KAVYAJOSHI1/PUREROUTE/app.py

"""
PureRoute v2 — Professional Industrial Water Monitoring & Decision Console
Designed for high-reliability municipal & decentralized water purification systems.
Design Language: Minimal, functional, data-first industrial SCADA (Linear / Vercel / Stripe standard).
"""

import os
import time
from datetime import datetime, date, timedelta
from typing import Dict, Any, List, Optional
import pandas as pd
import streamlit as st

from engine.decision_engine import DecisionEngine, State, CalibrationConstants
from engine.lock_module import AreaLockEngine, BIS_LIMITS, PARAM_LABELS
from engine.simulator import WaterRigSimulator
from engine.serial_reader import SerialManager
from engine.ui_components import (
    clean_html,
    render_status_badge,
    render_connection_chip,
    render_top_header,
    render_system_status_banner,
    render_metric_card,
    render_filter_health_card,
    render_decision_matrix_table,
    create_light_telemetry_chart,
    render_card_header,
    render_contaminant_indicator_card
)
from tools.calibration_helper import CalibrationHelper

# ---------------------------------------------------------
# Page Configuration & Global Industrial Theme
# ---------------------------------------------------------
st.set_page_config(
    page_title="PureRoute — Industrial Water Monitoring & Decision Console",
    page_icon="💧",
    layout="wide",
    initial_sidebar_state="expanded"
)

# Professional Industrial Styling (Light Mode strictly)
st.markdown("""
<style>
    @import url('https://fonts.googleapis.com/css2?family=Inter:wght@400;500;600;700&family=JetBrains+Mono:wght@400;500;600&display=swap');

    /* Remove Streamlit Default Chrome */
    #MainMenu { visibility: hidden !important; }
    footer { visibility: hidden !important; }
    header, .stAppHeader, header[data-testid="stHeader"] { display: none !important; }
    .stDeployButton, div[data-testid="stAppDeployButton"] { display: none !important; }
    div[data-testid="stDecoration"] { display: none !important; }

    /* Global Foundation */
    .stApp {
        background-color: #F7F8FA !important;
        color: #20242B !important;
        font-family: 'Inter', -apple-system, BlinkMacSystemFont, 'Segoe UI', Roboto, sans-serif !important;
    }

    /* Fixed Left Sidebar (240px) */
    section[data-testid="stSidebar"] {
        width: 240px !important;
        background-color: #FFFFFF !important;
        border-right: 1px solid #E5E7EB !important;
        padding-top: 1rem !important;
    }
    section[data-testid="stSidebar"] .block-container {
        padding-top: 1rem !important;
        padding-bottom: 2rem !important;
        padding-left: 14px !important;
        padding-right: 14px !important;
    }

    /* Brand Header in Sidebar */
    .brand-container {
        padding: 0 4px 16px 4px;
        border-bottom: 1px solid #E5E7EB;
        margin-bottom: 16px;
    }
    .brand-title {
        font-family: 'Inter', sans-serif;
        font-size: 16px;
        font-weight: 700;
        color: #20242B;
        letter-spacing: -0.02em;
        display: flex;
        align-items: center;
        gap: 8px;
    }
    .brand-sub {
        font-size: 10px;
        font-weight: 600;
        color: #68717D;
        margin-top: 3px;
        text-transform: uppercase;
        letter-spacing: 0.06em;
    }

    /* Navigation Radio Items Restyled into Linear-Style Sidebar Links */
    div[data-testid="stRadio"] div[data-testid="stRadioGroup"] {
        gap: 3px !important;
    }
    label[data-testid="stRadioOption"] {
        background-color: transparent !important;
        border: 1px solid transparent !important;
        border-radius: 6px !important;
        padding: 7px 10px !important;
        margin-bottom: 2px !important;
        width: 100% !important;
        display: flex !important;
        align-items: center !important;
        cursor: pointer !important;
        transition: all 0.12s ease !important;
    }
    /* Hide the radio circle completely */
    label[data-testid="stRadioOption"] > div > div:first-child {
        display: none !important;
    }
    label[data-testid="stRadioOption"] > div {
        display: flex !important;
        align-items: center !important;
        width: 100% !important;
    }
    label[data-testid="stRadioOption"] p {
        font-size: 13px !important;
        font-weight: 500 !important;
        color: #4B5563 !important;
        margin: 0 !important;
        line-height: 1.4 !important;
    }
    label[data-testid="stRadioOption"]:hover {
        background-color: #F3F4F6 !important;
    }
    label[data-testid="stRadioOption"]:hover p {
        color: #111827 !important;
    }
    label[data-testid="stRadioOption"][data-selected="true"],
    label[data-testid="stRadioOption"]:has(input:checked) {
        background-color: #EDF2F5 !important;
        border-color: #D0DCE3 !important;
    }
    label[data-testid="stRadioOption"][data-selected="true"] p,
    label[data-testid="stRadioOption"]:has(input:checked) p {
        color: #315B73 !important;
        font-weight: 600 !important;
    }

    /* Main Content Container (Max 1500px, 24px padding) */
    .main .block-container {
        max-width: 1500px !important;
        padding: 20px 32px 48px 32px !important;
    }

    /* Industrial Card Surface */
    .pr-card {
        background: #FFFFFF;
        border: 1px solid #E5E7EB;
        border-radius: 6px;
        padding: 16px 20px;
        margin-bottom: 16px;
        box-shadow: 0 1px 2px rgba(0,0,0,0.02);
    }
    .pr-card-header {
        display: flex;
        justify-content: space-between;
        align-items: center;
        margin-bottom: 12px;
        padding-bottom: 8px;
        border-bottom: 1px solid #F1F3F5;
    }
    .pr-card-title {
        font-size: 12px;
        font-weight: 600;
        text-transform: uppercase;
        letter-spacing: 0.05em;
        color: #68717D;
    }

    /* Enterprise Clean Button Styling */
    div.stButton > button {
        background-color: #FFFFFF !important;
        color: #20242B !important;
        border: 1px solid #D1D5DB !important;
        border-radius: 5px !important;
        font-size: 13px !important;
        font-weight: 500 !important;
        padding: 6px 14px !important;
        box-shadow: 0 1px 2px rgba(0,0,0,0.03) !important;
        transition: all 0.12s ease !important;
    }
    div.stButton > button:hover {
        background-color: #F9FAFB !important;
        border-color: #9CA3AF !important;
        color: #111827 !important;
    }
    div.stButton > button:active {
        background-color: #F3F4F6 !important;
    }

    /* Danger / Primary Button Overrides */
    div.stButton > button[kind="primary"],
    div.stButton > button[data-testid="baseButton-primary"] {
        background-color: #B94A48 !important;
        color: #FFFFFF !important;
        border-color: #93302E !important;
    }
    div.stButton > button[kind="primary"]:hover,
    div.stButton > button[data-testid="baseButton-primary"]:hover {
        background-color: #93302E !important;
    }

    /* Native Container Card Surfaces (st.container(border=True)) */
    div[data-testid="stVerticalBlockBorderWrapper"] {
        background-color: #FFFFFF !important;
        border: 1px solid #E5E7EB !important;
        border-radius: 6px !important;
        padding: 16px 20px !important;
        margin-bottom: 16px !important;
        box-shadow: 0 1px 2px rgba(0,0,0,0.02) !important;
    }

    /* Selectbox Dropdown Options and Value styling */
    div[data-baseweb="select"],
    div[data-baseweb="select"] * {
        background-color: #FFFFFF !important;
        color: #20242B !important;
    }
    div[data-baseweb="select"] > div {
        background-color: #FFFFFF !important;
        color: #20242B !important;
        border: 1px solid #D1D5DB !important;
        border-radius: 5px !important;
    }
    div[data-baseweb="popover"],
    div[data-baseweb="popover"] *,
    div[data-baseweb="menu"],
    div[data-baseweb="menu"] * {
        background-color: #FFFFFF !important;
        color: #20242B !important;
    }
    div[data-baseweb="calendar"],
    div[data-baseweb="calendar"] * {
        background-color: #FFFFFF !important;
        color: #20242B !important;
    }
    li[data-baseweb="menu-item"]:hover {
        background-color: #F3F4F6 !important;
    }

    /* Text & Select Inputs */
    div[data-baseweb="input"],
    div[data-baseweb="base-input"],
    div[data-testid="stTextInputRootElement"],
    div[data-testid="stNumberInputContainer"],
    div[data-testid="stDateInput"] > div {
        background-color: #FFFFFF !important;
        border: 1px solid #D1D5DB !important;
        border-radius: 5px !important;
    }
    div[data-baseweb="input"] input,
    div[data-baseweb="base-input"] input,
    input[data-testid="stTextInputField"],
    div[data-testid="stNumberInputContainer"] input,
    div[data-testid="stDateInput"] input {
        background-color: #FFFFFF !important;
        color: #20242B !important;
        font-family: 'JetBrains Mono', monospace !important;
        font-size: 13px !important;
    }

    /* Tables & DataFrames */
    .stDataFrame {
        border: 1px solid #E5E7EB !important;
        border-radius: 6px !important;
        background: #FFFFFF !important;
    }

    /* Monospace Code blocks */
    code, pre {
        font-family: 'JetBrains Mono', monospace !important;
    }
</style>
""", unsafe_allow_html=True)

# ---------------------------------------------------------
# Session State Initialization
# ---------------------------------------------------------
if "engine" not in st.session_state:
    st.session_state.engine = DecisionEngine()
if "simulator" not in st.session_state:
    st.session_state.simulator = WaterRigSimulator(st.session_state.engine)
if "lock_engine" not in st.session_state:
    st.session_state.lock_engine = AreaLockEngine("district_risk.csv")
if "data_history" not in st.session_state:
    st.session_state.data_history = []
if "log_filename" not in st.session_state:
    st.session_state.log_filename = time.strftime("run_%Y%m%d_%H%M%S.csv")
    with open(st.session_state.log_filename, "w", encoding="utf-8") as f:
        f.write("t_ms,temp_c,flow_lpm,pulses,turb_mv,turb_index_pct,ec25_uScm,tds_ppm,fhi,counter_life_pct,pump,lock,state,reason,tag\n")

if "serial_manager" not in st.session_state:
    st.session_state.serial_manager = SerialManager()
if "use_hardware_serial" not in st.session_state:
    st.session_state.use_hardware_serial = False
if "current_test_record" not in st.session_state:
    st.session_state.current_test_record = None
if "command_log" not in st.session_state:
    st.session_state.command_log = ["System initialized on Standby.", "Telemetry stream active at 1 Hz."]
if "live_streaming" not in st.session_state:
    st.session_state.live_streaming = True

eng: DecisionEngine = st.session_state.engine
sim: WaterRigSimulator = st.session_state.simulator
lock_eng: AreaLockEngine = st.session_state.lock_engine

# Helper to dispatch Arduino / Sim command and record in audit log
def dispatch_serial_command(cmd_str: str, desc: str):
    ts = datetime.now().strftime("%H:%M:%S")
    if st.session_state.use_hardware_serial:
        if st.session_state.serial_manager.running:
            ok = st.session_state.serial_manager.send_command(cmd_str)
            status_text = f"[{ts}] SENT (USB): '{cmd_str}' &bull; {desc} &bull; ACK: OK"
            st.toast(f"Dispatched to Arduino: {cmd_str}")
        else:
            status_text = f"[{ts}] FAILED: '{cmd_str}' &bull; Serial disconnected"
            st.error("Cannot dispatch: Arduino USB serial is disconnected.")
    else:
        # Simulation interpretation
        if cmd_str == "P1":
            sim.pump_on = 1
        elif cmd_str == "P0":
            sim.pump_on = 0
        elif cmd_str == "B":
            eng.reset_baseline_v0(sim.turb_mv)
        elif cmd_str == "F":
            eng.reset_baseline_q0(sim.flow_lpm)
        elif cmd_str.startswith("K"):
            try:
                kval = float(cmd_str[1:])
                eng.set_calibration(k_flow=kval)
            except Exception:
                pass
        elif cmd_str.startswith("S"):
            tag_name = cmd_str[1:]
            eng.current_tag = tag_name
        elif cmd_str == "L1":
            eng.area_locked = True
        elif cmd_str == "L0":
            eng.area_locked = False

        status_text = f"[{ts}] SIM RIG: '{cmd_str}' &bull; {desc} &bull; APPLIED"
        st.toast(f"Command executed: {cmd_str}")

    st.session_state.command_log.insert(0, status_text)
    if len(st.session_state.command_log) > 20:
        st.session_state.command_log.pop()

# ---------------------------------------------------------
# Sidebar Navigation & System Setup
# ---------------------------------------------------------
with st.sidebar:
    st.markdown("""
    <div class="brand-container">
        <div class="brand-title">
            <svg width="18" height="18" viewBox="0 0 24 24" fill="none" stroke="#315B73" stroke-width="2.5" stroke-linecap="round" stroke-linejoin="round">
                <path d="M12 2.69l5.66 5.66a8 8 0 1 1-11.31 0z"></path>
            </svg>
            PureRoute v2
        </div>
        <div class="brand-sub">Intelligent Water SCADA</div>
    </div>
    """, unsafe_allow_html=True)

    st.caption("SYSTEM NAVIGATION")
    NAV_ITEMS = [
        "⊞ Overview",
        "〰 Live Monitoring",
        "⏣ Filter Health",
        "⌥ Decision Engine",
        "◎ Area Risk",
        "☑ Test Results",
        "☲ Historical Logs",
        "⚙ Calibration & Settings"
    ]
    default_nav_idx = 0
    qp_page = st.query_params.get("page", "")
    if qp_page:
        for idx, item in enumerate(NAV_ITEMS):
            if qp_page.lower() in item.lower():
                default_nav_idx = idx
                break

    nav_selection_raw = st.radio(
        "Navigation",
        options=NAV_ITEMS,
        index=default_nav_idx,
        label_visibility="collapsed"
    )
    # Strip leading icon for logical routing
    nav_selection = nav_selection_raw.split(" ", 1)[1] if " " in nav_selection_raw else nav_selection_raw

    st.markdown("<div style='margin-top: 24px;'></div>", unsafe_allow_html=True)
    st.caption("HARDWARE INTERFACE")
    
    hardware_mode = st.radio(
        "Interface",
        options=["HIL Simulation Rig", "Arduino USB Serial"],
        index=1 if st.session_state.use_hardware_serial else 0,
        label_visibility="collapsed"
    )
    st.session_state.use_hardware_serial = (hardware_mode == "Arduino USB Serial")

    if st.session_state.use_hardware_serial:
        avail_ports = SerialManager.list_available_ports()
        selected_port = st.selectbox(
            "Serial Port",
            options=avail_ports or ["/dev/ttyACM0", "/dev/ttyUSB0", "COM3"],
            index=0,
            label_visibility="collapsed"
        )
        col_c1, col_c2 = st.columns(2)
        with col_c1:
            if st.button("Connect", disabled=st.session_state.serial_manager.running, width="stretch"):
                ok = st.session_state.serial_manager.start(selected_port)
                if ok:
                    st.toast(f"Connected to {selected_port}")
        with col_c2:
            if st.button("Disconnect", disabled=not st.session_state.serial_manager.running, width="stretch"):
                st.session_state.serial_manager.stop()
                st.toast("Serial connection closed")

    st.markdown("<div style='margin-top: 16px;'></div>", unsafe_allow_html=True)
    st.caption("DEVICE NODE")
    st.markdown("""
    <div style="font-size: 12px; font-weight: 500; color: #4B5563; padding: 2px 0;">
        Node P-01 &bull; Atomberg Bench Rig<br>
        <span style="font-size: 11px; color: #68717D; font-family: 'JetBrains Mono', monospace;">FW v2.1 &bull; ATmega328P @ 115.2k</span>
    </div>
    """, unsafe_allow_html=True)

# ---------------------------------------------------------
# Telemetry Acquisition Routine
# ---------------------------------------------------------
def get_current_frame() -> Dict[str, Any]:
    """Acquires frame either from active USB serial or simulator."""
    if st.session_state.use_hardware_serial and st.session_state.serial_manager.running:
        latest = st.session_state.serial_manager.get_latest_frame()
        if latest:
            return {
                "t_ms": int(latest["t_ms"]),
                "temp_c": float(latest["temp_c"]),
                "flow_lpm": float(latest["flow_lpm"]),
                "pulses": int(latest["pulses"]),
                "turb_mv": float(latest["turb_mv"]),
                "turb_index_pct": float(latest["turb_index_pct"]),
                "ec25_uScm": float(latest["ec25_uScm"]),
                "tds_ppm": float(latest["tds_ppm"]),
                "fhi": float(latest["fhi"]),
                "counter_life_pct": float(latest["counter_life_pct"]),
                "pump": int(latest["pump"]),
                "lock": int(latest["lock"]),
                "state": latest["state"],
                "reason": latest["reason"],
                "tag": latest["tag"],
                "manometer_cm": 5.0 + max(0.0, (1.2 - float(latest["flow_lpm"])) * 22.0)
            }
        return {}
    else:
        frame = sim.step()
        d = frame.to_dict()
        d["manometer_cm"] = sim.manometer_cm
        return d

# Acquire telemetry frame and maintain 600-second buffer
frame = get_current_frame()
if frame:
    st.session_state.data_history.append(frame)
    if len(st.session_state.data_history) > 600:
        st.session_state.data_history.pop(0)

    try:
        with open(st.session_state.log_filename, "a", encoding="utf-8") as f:
            f.write(
                f"{frame['t_ms']},{frame['temp_c']:.2f},{frame['flow_lpm']:.2f},"
                f"{frame['pulses']},{frame['turb_mv']:.1f},{frame['turb_index_pct']:.1f},"
                f"{frame['ec25_uScm']:.1f},{frame['tds_ppm']:.1f},{frame['fhi']:.1f},"
                f"{frame['counter_life_pct']:.1f},{frame['pump']},{frame['lock']},"
                f"{frame['state']},{frame['reason']},{frame['tag']}\n"
            )
    except Exception:
        pass

# Safe accessors for current telemetry variables
cur_state = frame.get("state", "UF+UV")
cur_reason = frame.get("reason", "Nominal operation")
cur_pump = frame.get("pump", 1) == 1
cur_temp = frame.get("temp_c", 24.5)
cur_flow = frame.get("flow_lpm", 1.15)
cur_ec = frame.get("ec25_uScm", 250.0)
cur_tds = frame.get("tds_ppm", cur_ec * 0.6)
cur_ti = frame.get("turb_index_pct", 2.5)
cur_fhi = frame.get("fhi", 100.0)
cur_counter = frame.get("counter_life_pct", 99.4)
cur_lock = frame.get("lock", 0) == 1
cur_mano = frame.get("manometer_cm", 5.2)
cur_t_ms = frame.get("t_ms", 0)

# Prepare DataFrame for analytical charts
df_hist = pd.DataFrame(st.session_state.data_history)
if not df_hist.empty and "t_ms" in df_hist.columns:
    df_hist["time_s"] = (df_hist["t_ms"] - df_hist["t_ms"].iloc[0]) / 1000.0
else:
    df_hist = pd.DataFrame()

# ---------------------------------------------------------
# Top Header Bar (Breadcrumb, Connection Chip, Stream Pulse)
# ---------------------------------------------------------
is_hw = st.session_state.use_hardware_serial
is_conn = st.session_state.serial_manager.running
port_str = st.session_state.serial_manager.port if is_hw else ""
header_html = render_top_header(
    page_name=nav_selection,
    is_hardware=is_hw,
    is_connected=is_conn,
    port=port_str,
    last_updated=datetime.now().strftime("%H:%M:%S"),
    is_paused=not st.session_state.live_streaming
)
st.markdown(header_html, unsafe_allow_html=True)

# =========================================================
# PAGE 1: OVERVIEW
# =========================================================
if nav_selection == "Overview":
    # 5.A System Status Banner
    banner_html = render_system_status_banner(
        state=cur_state,
        reason=cur_reason,
        pump_on=cur_pump,
        lock_active=cur_lock,
        faults_count=len(eng.active_faults),
        t_ms=cur_t_ms
    )
    st.markdown(banner_html, unsafe_allow_html=True)

    # 5.B Live Sensor Metrics (4 Primary Cards + derived TDS)
    m1, m2, m3, m4 = st.columns(4)
    with m1:
        st.markdown(render_metric_card(
            title="Water Temperature",
            value_str=f"{cur_temp:.1f}",
            unit="°C",
            sensor_chip="DS18B20",
            subtext="Range: 0.0–50.0 °C (Nominal)",
            status_level="ok" if 0 <= cur_temp <= 50 else "fault"
        ), unsafe_allow_html=True)

    with m2:
        flow_lvl = "ok" if cur_flow >= 0.3 else ("warn" if cur_flow > 0.05 else "fault")
        st.markdown(render_metric_card(
            title="Flow Rate (Q)",
            value_str=f"{cur_flow:.2f}",
            unit="L/min",
            sensor_chip="YF-S401",
            subtext=f"Baseline Q0: {eng.cal.q0_fresh_flow:.2f} L/min",
            status_level=flow_lvl
        ), unsafe_allow_html=True)

    with m3:
        ec_lvl = "ok" if cur_ec <= 500 else "warn"
        st.markdown(render_metric_card(
            title="Conductivity (EC25)",
            value_str=f"{cur_ec:.0f}",
            unit="µS/cm",
            sensor_chip="SS304 BIPOLAR",
            subtext=f"Derived TDS: {cur_tds:.0f} ppm (k=0.6)",
            status_level=ec_lvl
        ), unsafe_allow_html=True)

    with m4:
        ti_lvl = "ok" if cur_ti < 25 else "warn"
        st.markdown(render_metric_card(
            title="Turbidity Index (TI)",
            value_str=f"{cur_ti:.1f}",
            unit="%",
            sensor_chip="OPTICAL TIP",
            subtext="Flush Trigger: > 25.0% TI",
            status_level=ti_lvl
        ), unsafe_allow_html=True)

    st.markdown("<div style='margin-top: 16px;'></div>", unsafe_allow_html=True)

    # 5.C Filter Health & 5.D Decision Hierarchy
    c_fh, c_dec = st.columns([1.3, 1.7])
    with c_fh:
        pred_min = eng.predict_minutes_to_replace()
        st.markdown(render_filter_health_card(
            fhi=cur_fhi,
            counter_pct=cur_counter,
            flow=cur_flow,
            q0=eng.cal.q0_fresh_flow,
            litres=eng.total_litres_dispensed,
            rated_litres=eng.cal.rated_litres,
            manometer_cm=cur_mano,
            pred_minutes=pred_min
        ), unsafe_allow_html=True)

    with c_dec:
        st.markdown(render_decision_matrix_table(current_state=cur_state), unsafe_allow_html=True)

    # 5.E Live Time-Series Charts (Enclosed in clean Card)
    st.markdown("<div style='margin-top: 20px;'></div>", unsafe_allow_html=True)
    with st.container(border=True):
        st.markdown("""
        <div class="pr-card-header">
            <span class="pr-card-title">Real-Time Telemetry Trends (600s Buffer)</span>
            <span style="font-size: 11px; color: #68717D; font-family: 'JetBrains Mono', monospace;">1 Hz USB Sample Stream</span>
        </div>
        """, unsafe_allow_html=True)

        if not df_hist.empty:
            ch1, ch2 = st.columns(2)
            with ch1:
                fig_ec = create_light_telemetry_chart(
                    df=df_hist,
                    col_name="ec25_uScm",
                    title="Conductivity (EC25)",
                    unit="µS/cm",
                    line_color="#315B73",
                    thresholds=[
                        {"value": 500, "color": "#B98536", "label": "RO Switch (500)", "dash": "dash"},
                        {"value": 450, "color": "#39815B", "label": "UF Return (450)", "dash": "dot"}
                    ],
                    height=185
                )
                st.plotly_chart(fig_ec, width="stretch", config={"displayModeBar": False}, key="ov_chart_ec")

                fig_fhi = create_light_telemetry_chart(
                    df=df_hist,
                    col_name="fhi",
                    title="Filter Health (FHI) vs Usage Counter",
                    unit="%",
                    line_color="#39815B",
                    secondary_col="counter_life_pct",
                    secondary_name="Litre Counter",
                    secondary_color="#94A3B8",
                    thresholds=[
                        {"value": 40, "color": "#B94A48", "label": "Replace (40%)", "dash": "dash"}
                    ],
                    height=185
                )
                st.plotly_chart(fig_fhi, width="stretch", config={"displayModeBar": False}, key="ov_chart_fhi")

            with ch2:
                fig_ti = create_light_telemetry_chart(
                    df=df_hist,
                    col_name="turb_index_pct",
                    title="Turbidity Index (TI)",
                    unit="%",
                    line_color="#B98536",
                    thresholds=[
                        {"value": 25, "color": "#B94A48", "label": "Flush Spike (25%)", "dash": "dash"},
                        {"value": 10, "color": "#39815B", "label": "Clear (10%)", "dash": "dot"}
                    ],
                    height=185
                )
                st.plotly_chart(fig_ti, width="stretch", config={"displayModeBar": False}, key="ov_chart_ti")

                fig_fl = create_light_telemetry_chart(
                    df=df_hist,
                    col_name="flow_lpm",
                    title="Flow Rate (Q)",
                    unit="L/min",
                    line_color="#477AAB",
                    thresholds=[
                        {"value": 0.3, "color": "#B94A48", "label": "Min Safe Flow (0.3)", "dash": "dash"}
                    ],
                    height=185
                )
                st.plotly_chart(fig_fl, width="stretch", config={"displayModeBar": False}, key="ov_chart_flow")

            fig_temp = create_light_telemetry_chart(
                df=df_hist,
                col_name="temp_c",
                title="Water Temperature",
                unit="°C",
                line_color="#64748B",
                thresholds=[
                    {"value": 50, "color": "#B94A48", "label": "Max Safe Temp (50°C)", "dash": "dash"},
                    {"value": 0, "color": "#315B73", "label": "Min Safe Temp (0°C)", "dash": "dash"}
                ],
                height=160
            )
            st.plotly_chart(fig_temp, width="stretch", config={"displayModeBar": False}, key="ov_chart_temp")

    # Section 6: Essential Hardware Control Panel (Permanent Card)
    with st.container(border=True):
        st.markdown("""
        <div class="pr-card-header">
            <span class="pr-card-title">Essential Hardware & Serial Actuator Control Panel</span>
            <span style="font-family: 'JetBrains Mono', monospace; font-size: 11px; color: #68717D;">Arduino Protocol &bull; 115200 Baud</span>
        </div>
        """, unsafe_allow_html=True)

        ctrl_col1, ctrl_col2, ctrl_col3, ctrl_col4 = st.columns([1.2, 1, 1.2, 1.6])
        with ctrl_col1:
            st.markdown("<div style='font-size: 11px; font-weight: 600; text-transform: uppercase; color: #68717D; margin-bottom: 6px;'>Pump Actuator</div>", unsafe_allow_html=True)
            chk_confirm = st.checkbox("Confirm pump activation", key="ov_chk_pump_confirm")
            if st.button("PUMP ON (P1)", disabled=not chk_confirm, width="stretch"):
                dispatch_serial_command("P1", "Dispense pump relay energized")
            if st.button("PUMP OFF (P0)", width="stretch"):
                dispatch_serial_command("P0", "Dispense pump relay de-energized")

        with ctrl_col2:
            st.markdown("<div style='font-size: 11px; font-weight: 600; text-transform: uppercase; color: #68717D; margin-bottom: 6px;'>Calibration EEPROM</div>", unsafe_allow_html=True)
            if st.button("SAVE V0 (B)", width="stretch"):
                dispatch_serial_command("B", "Saved current optical voltage as clear-water V0")
            if st.button("SAVE Q0 (F)", width="stretch"):
                dispatch_serial_command("F", "Saved current flow as fresh-cartridge Q0")

        with ctrl_col3:
            st.markdown("<div style='font-size: 11px; font-weight: 600; text-transform: uppercase; color: #68717D; margin-bottom: 6px;'>Regional Lock & Sample Tag</div>", unsafe_allow_html=True)
            if cur_lock:
                if st.button("RELEASE LOCK (L0)", width="stretch"):
                    dispatch_serial_command("L0", "Manual release of regional risk lock")
            else:
                if st.button("FORCE RO LOCK (L1)", width="stretch"):
                    dispatch_serial_command("L1", "Manual enforcement of RO lock")

            tag_input = st.text_input("Sample Tag", value="BENCH_01", label_visibility="collapsed")
            if st.button("TAG SAMPLE (S<tag>)", width="stretch"):
                dispatch_serial_command(f"S{tag_input.strip()}", f"Sample stream tagged as '{tag_input.strip()}'")

        with ctrl_col4:
            st.markdown("<div style='font-size: 11px; font-weight: 600; text-transform: uppercase; color: #68717D; margin-bottom: 6px;'>Emergency Protection</div>", unsafe_allow_html=True)
            if st.button("EMERGENCY STOP", type="primary", width="stretch"):
                dispatch_serial_command("P0", "EMERGENCY SHUTDOWN ACTIVATED")
                sim.pump_on = 0
                st.error("Emergency Stop Activated: Actuators de-energized.")

            st.markdown("<div style='font-size: 11px; color: #68717D; margin-top: 6px; line-height: 1.4;'>Hardware safety note: Emergency stop disengages pump immediately. Physical safety interlocks on Arduino Uno cannot be bypassed.</div>", unsafe_allow_html=True)

        if not st.session_state.use_hardware_serial:
            st.markdown("<div style='margin-top: 14px; padding-top: 10px; border-top: 1px solid #E5E7EB;'></div>", unsafe_allow_html=True)
            st.markdown("<div style='font-size: 11px; font-weight: 600; text-transform: uppercase; letter-spacing: 0.05em; color: #68717D; margin-bottom: 8px;'>HIL BENCH RIG SCENARIO INJECTION</div>", unsafe_allow_html=True)
            sc1, sc2, sc3, sc4, sc5 = st.columns(5)
            with sc1:
                if st.button("Clean Tap Water", width="stretch"):
                    sim.set_scenario("CLEAN")
                    dispatch_serial_command("CLEAN", "Injected clean municipal tap water scenario")
            with sc2:
                if st.button("Saline 1.0 g/L", width="stretch"):
                    sim.set_scenario("SALTY_1G")
                    dispatch_serial_command("SALTY", "Injected 1.0 g/L NaCl high dissolved solids scenario")
            with sc3:
                if st.button("Turbidity Spike", width="stretch"):
                    sim.set_scenario("TURBIDITY_SPIKE")
                    dispatch_serial_command("SPIKE", "Injected sudden silt intrusion turbidity spike")
            with sc4:
                if st.button("Clogging Ramp", width="stretch"):
                    sim.set_scenario("CLOGGING_RAMP")
                    dispatch_serial_command("CLOG", "Injected membrane silt fouling clogging ramp")
            with sc5:
                if st.button("Clear Faults", width="stretch"):
                    sim.clear_faults()
                    dispatch_serial_command("RESET", "Cleared all injected faults and simulated errors")

        # Serial Command Audit Log
        st.markdown("<div style='margin-top: 14px; font-size: 11px; font-weight: 600; color: #68717D; text-transform: uppercase;'>Dispatched Serial Command Receipt Audit Log:</div>", unsafe_allow_html=True)
        log_box = "<br>".join([f"<span style='font-family: monospace; font-size: 11px; color: #4B5563;'>{entry}</span>" for entry in st.session_state.command_log[:5]])
        st.markdown(f"<div style='background: #F9FAFB; border: 1px solid #E5E7EB; border-radius: 4px; padding: 8px 12px; line-height: 1.5;'>{log_box}</div>", unsafe_allow_html=True)

# =========================================================
# PAGE 2: LIVE MONITORING
# =========================================================
elif nav_selection == "Live Monitoring":
    st.markdown("""
    <div style="font-size: 13px; color: #68717D; margin-bottom: 16px; line-height: 1.5;">
        Real-time hardware acquisition bus and diagnostic signal telemetry stream from ATmega328P microcontroller at 115200 baud.
    </div>
    """, unsafe_allow_html=True)

    with st.container(border=True):
        st.markdown(render_card_header(
            "Hardware Telemetry & Sensor Signal Integrity",
            "1 Hz USB Data Stream • ATmega328P @ 115200 Baud"
        ), unsafe_allow_html=True)

        pulses_val = frame.get('pulses', 0)
        turb_mv_val = frame.get('turb_mv', 2000.0)

        st.markdown(clean_html(f"""
        <table style="width: 100%; font-size: 13px; border-collapse: collapse;">
            <thead>
                <tr style="border-bottom: 1px solid #E5E7EB; color: #68717D; font-size: 11px; text-transform: uppercase; letter-spacing: 0.04em; text-align: left;">
                    <th style="padding: 7px 8px;">Sensor Channel</th>
                    <th style="padding: 7px 8px;">Pin Wiring</th>
                    <th style="padding: 7px 8px;">Raw Acquisition</th>
                    <th style="padding: 7px 8px;">Processed Value</th>
                    <th style="padding: 7px 8px;">Nominal Benchmark</th>
                    <th style="padding: 7px 8px; text-align: right;">Diagnostic State</th>
                </tr>
            </thead>
            <tbody>
                <tr style="border-bottom: 1px solid #F1F3F5;">
                    <td style="padding: 9px 8px; font-weight: 600;">Dallas DS18B20</td>
                    <td style="padding: 9px 8px; font-family: monospace; color: #4B5563;">Pin D4 (4.7kΩ Pull-up)</td>
                    <td style="padding: 9px 8px; font-family: monospace;">1-Wire 11-bit CRC</td>
                    <td style="padding: 9px 8px; font-family: monospace; font-weight: 600;">{cur_temp:.2f} °C</td>
                    <td style="padding: 9px 8px; color: #68717D;">0.0 to 50.0 °C</td>
                    <td style="padding: 9px 8px; text-align: right;"><span style="color: #235E3F; background: #EBF5F0; border: 1px solid #C6E7D4; padding: 2px 7px; border-radius: 3px; font-size: 10px; font-weight: 600;">HEALTHY</span></td>
                </tr>
                <tr style="border-bottom: 1px solid #F1F3F5;">
                    <td style="padding: 9px 8px; font-weight: 600;">YF-S401 Flow Turbine</td>
                    <td style="padding: 9px 8px; font-family: monospace; color: #4B5563;">Pin D2 (INT0 Vector)</td>
                    <td style="padding: 9px 8px; font-family: monospace;">{pulses_val} pulses/s</td>
                    <td style="padding: 9px 8px; font-family: monospace; font-weight: 600;">{cur_flow:.2f} L/min</td>
                    <td style="padding: 9px 8px; color: #68717D;">0.3 to 1.5 L/min (Pump ON)</td>
                    <td style="padding: 9px 8px; text-align: right;"><span style="color: #235E3F; background: #EBF5F0; border: 1px solid #C6E7D4; padding: 2px 7px; border-radius: 3px; font-size: 10px; font-weight: 600;">FLOWING</span></td>
                </tr>
                <tr style="border-bottom: 1px solid #F1F3F5;">
                    <td style="padding: 9px 8px; font-weight: 600;">Turbidity Optical Tip</td>
                    <td style="padding: 9px 8px; font-family: monospace; color: #4B5563;">Pin A0 (100nF Filter)</td>
                    <td style="padding: 9px 8px; font-family: monospace;">{turb_mv_val:.1f} mV</td>
                    <td style="padding: 9px 8px; font-family: monospace; font-weight: 600;">TI = {cur_ti:.1f} %</td>
                    <td style="padding: 9px 8px; color: #68717D;">V0: {eng.cal.v0_turb_mv:.0f} mV (100–2400 mV)</td>
                    <td style="padding: 9px 8px; text-align: right;"><span style="color: #235E3F; background: #EBF5F0; border: 1px solid #C6E7D4; padding: 2px 7px; border-radius: 3px; font-size: 10px; font-weight: 600;">NOMINAL</span></td>
                </tr>
                <tr style="border-bottom: 1px solid #F1F3F5;">
                    <td style="padding: 9px 8px; font-weight: 600;">SS304 Bipolar Probe</td>
                    <td style="padding: 9px 8px; font-family: monospace; color: #4B5563;">Pins D7, D8, A1</td>
                    <td style="padding: 9px 8px; font-family: monospace;">Rx: {sim.rx_ohms:.0f} Ω (Asym {sim.rx_asym*100:.1f}%)</td>
                    <td style="padding: 9px 8px; font-family: monospace; font-weight: 600;">{cur_ec:.0f} µS/cm</td>
                    <td style="padding: 9px 8px; color: #68717D;">100 to 1500 µS/cm</td>
                    <td style="padding: 9px 8px; text-align: right;"><span style="color: #235E3F; background: #EBF5F0; border: 1px solid #C6E7D4; padding: 2px 7px; border-radius: 3px; font-size: 10px; font-weight: 600;">SYMMETRIC</span></td>
                </tr>
                <tr>
                    <td style="padding: 9px 8px; font-weight: 600;">Manometer Backpressure</td>
                    <td style="padding: 9px 8px; font-family: monospace; color: #4B5563;">Vertical Water Tube</td>
                    <td style="padding: 9px 8px; font-family: monospace;">Hydrostatic Head</td>
                    <td style="padding: 9px 8px; font-family: monospace; font-weight: 600;">h = {cur_mano:.1f} cm</td>
                    <td style="padding: 9px 8px; color: #68717D;">Fresh: 5–7 cm | Clogged: 18–26 cm</td>
                    <td style="padding: 9px 8px; text-align: right;"><span style="color: #235E3F; background: #EBF5F0; border: 1px solid #C6E7D4; padding: 2px 7px; border-radius: 3px; font-size: 10px; font-weight: 600;">LOW RESISTANCE</span></td>
                </tr>
            </tbody>
        </table>
        """), unsafe_allow_html=True)

    if not df_hist.empty:
        with st.container(border=True):
            st.markdown(render_card_header(
                "Full High-Resolution Oscilloscope Telemetry",
                "Conductivity (EC25) & Turbidity Attenuation Index"
            ), unsafe_allow_html=True)

            f_c1, f_c2 = st.columns(2)
            with f_c1:
                fig_f_ec = create_light_telemetry_chart(df_hist, "ec25_uScm", "Conductivity (EC25)", "µS/cm", line_color="#315B73", height=220)
                st.plotly_chart(fig_f_ec, width="stretch", config={"displayModeBar": False}, key="lm_chart_ec")
            with f_c2:
                fig_f_ti = create_light_telemetry_chart(df_hist, "turb_index_pct", "Turbidity Attenuation Index", "%", line_color="#B98536", height=220)
                st.plotly_chart(fig_f_ti, width="stretch", config={"displayModeBar": False}, key="lm_chart_ti")

# =========================================================
# PAGE 3: FILTER HEALTH
# =========================================================
elif nav_selection == "Filter Health":
    st.markdown("""
    <div style="font-size: 13px; color: #68717D; margin-bottom: 16px; line-height: 1.5;">
        Filter health in PureRoute v2 is derived directly from hydrodynamic membrane flow throughput ($Q / Q_0$), 
        completely preventing the dangerous false-confidence of legacy litre counters during premature silt fouling.
    </div>
    """, unsafe_allow_html=True)

    fh_k1, fh_k2, fh_k3 = st.columns(3)
    with fh_k1:
        st.markdown(render_metric_card(
            title="Measured Filter Health (FHI)",
            value_str=f"{cur_fhi:.1f}",
            unit="%",
            sensor_chip="FLOW RATIO",
            subtext=f"Q ({cur_flow:.2f}) / Q0 ({eng.cal.q0_fresh_flow:.2f})",
            status_level="ok" if cur_fhi >= 70 else ("warn" if cur_fhi >= 40 else "fault")
        ), unsafe_allow_html=True)

    with fh_k2:
        st.markdown(render_metric_card(
            title="Legacy Litre Counter",
            value_str=f"{cur_counter:.1f}",
            unit="%",
            sensor_chip="VOLUME INTEGRAL",
            subtext=f"Total: {eng.total_litres_dispensed:.1f} / {eng.cal.rated_litres:.0f} L",
            status_level="ok"
        ), unsafe_allow_html=True)

    with fh_k3:
        st.markdown(render_metric_card(
            title="Hydrostatic Backpressure",
            value_str=f"{cur_mano:.1f}",
            unit="cm",
            sensor_chip="MANOMETER",
            subtext="Baseline Fresh: 5.0 cm",
            status_level="ok" if cur_mano < 15 else "warn"
        ), unsafe_allow_html=True)

    st.markdown("<div style='margin-top: 16px;'></div>", unsafe_allow_html=True)

    if not df_hist.empty:
        with st.container(border=True):
            st.markdown(render_card_header(
                "Direct Flow-Based FHI vs Litre-Counter Degradation Comparison",
                "Darcy's Law Hydrodynamic Analysis"
            ), unsafe_allow_html=True)

            fig_fhi_comp = create_light_telemetry_chart(
                df=df_hist,
                col_name="fhi",
                title="Measured FHI (Flow-Based)",
                unit="%",
                line_color="#39815B",
                secondary_col="counter_life_pct",
                secondary_name="Legacy Litre Counter (Volume-Based)",
                secondary_color="#94A3B8",
                thresholds=[
                    {"value": 40, "color": "#B94A48", "label": "REPLACE Mandatory (40%)", "dash": "dash"},
                    {"value": 70, "color": "#B98536", "label": "Clogging Warning (70%)", "dash": "dot"}
                ],
                height=260
            )
            st.plotly_chart(fig_fhi_comp, width="stretch", config={"displayModeBar": False}, key="fh_chart_comp")

            pred_min = eng.predict_minutes_to_replace()
            pred_text = f"~{pred_min} minutes" if pred_min is not None and pred_min > 0 else ("REPLACE THRESHOLD EXCEEDED" if cur_fhi < 40 else "Nominal Flow Rate")

            st.markdown(clean_html(f"""
            <div style="background: #F9FAFB; border: 1px solid #E5E7EB; border-radius: 4px; padding: 12px 14px; margin-top: 12px; font-size: 12px; line-height: 1.5;">
                <div style="font-weight: 600; color: #20242B; margin-bottom: 4px;">Darcy's Law Hydrodynamic Membrane Principle:</div>
                <div style="color: #4B5563;">
                    When silt or particulate cakes onto the ultrafiltration membrane surface, hydraulic resistance increases sharply. 
                    Flow rate drops from 1.20 L/min to 0.24 L/min within 35 seconds ($FHI = {cur_fhi:.1f}\\%$), while a blind volume counter barely registers 0.6% consumption (showing 99.4% false confidence). 
                    PureRoute detects premature clogging immediately and alerts the user to replace or backflush before contaminated water passes.
                </div>
                <div style="margin-top: 8px; font-family: 'JetBrains Mono', monospace; font-size: 11px; color: #315B73;">
                    FHI = (Q / Q0) × 100% &bull; Current Q={cur_flow:.2f} L/min &bull; Baseline Q0={eng.cal.q0_fresh_flow:.2f} L/min &bull; Replacement Projection: {pred_text}
                </div>
            </div>
            """), unsafe_allow_html=True)

# =========================================================
# PAGE 4: DECISION ENGINE
# =========================================================
elif nav_selection == "Decision Engine":
    st.markdown("""
    <div style="font-size: 13px; color: #68717D; margin-bottom: 16px; line-height: 1.5;">
        The decision engine checks operating states strictly top-to-bottom every second. A candidate state must hold for 
        <strong>5 consecutive seconds</strong> before transition, and only exits when hysteresis boundaries are satisfied.
    </div>
    """, unsafe_allow_html=True)

    with st.container(border=True):
        st.markdown(render_card_header(
            "Active Decision Evaluation Trace",
            f"Evaluated at {datetime.now().strftime('%H:%M:%S')} • 5s Hysteresis Lock"
        ), unsafe_allow_html=True)

        st.markdown(clean_html(f"""
        <div style="display: grid; grid-template-columns: 1fr 1fr; gap: 14px; font-size: 13px; line-height: 1.6;">
            <div style="background: #F9FAFB; border: 1px solid #E5E7EB; border-radius: 4px; padding: 12px 14px;">
                <div style="font-size: 11px; font-weight: 600; text-transform: uppercase; color: #68717D; margin-bottom: 6px;">Current Operating State</div>
                <div style="display: flex; align-items: center; gap: 8px; margin-bottom: 8px;">
                    {render_status_badge(cur_state)}
                    <span style="font-size: 13px; font-weight: 600; color: #20242B;">{cur_state}</span>
                </div>
                <div style="font-size: 12px; color: #4B5563; margin-bottom: 4px;"><strong>Decision Rationale:</strong> <code>{cur_reason}</code></div>
                <div style="font-size: 12px; color: #4B5563;"><strong>Dispense Actuator:</strong> {'ENERGIZED (12V ON)' if cur_pump else 'DE-ENERGIZED (OFF)'}</div>
            </div>
            <div style="background: #F9FAFB; border: 1px solid #E5E7EB; border-radius: 4px; padding: 12px 14px;">
                <div style="font-size: 11px; font-weight: 600; text-transform: uppercase; color: #68717D; margin-bottom: 6px;">Safety &amp; Regional Guards</div>
                <div style="font-size: 12px; color: #4B5563; margin-bottom: 4px;">
                    <strong>Fail-Safe Interlock:</strong> {'FAULT TRIP (PUMP CUTOFF)' if len(eng.active_faults) > 0 else 'ALL 7 PASS (CLEAR)'}
                </div>
                <div style="font-size: 12px; color: #4B5563; margin-bottom: 4px;">
                    <strong>Regional Risk Lock:</strong> {'ENFORCED (RO MANDATORY)' if cur_lock else 'NOT APPLIED (UF PERMITTED)'}
                </div>
                <div style="font-size: 12px; color: #4B5563;">
                    <strong>Persistence Counter:</strong> 5 / 5s (State Locked)
                </div>
            </div>
        </div>
        """), unsafe_allow_html=True)

    st.markdown("<div style='margin-top: 16px;'></div>", unsafe_allow_html=True)
    st.markdown(render_decision_matrix_table(current_state=cur_state), unsafe_allow_html=True)

    st.markdown("<div style='margin-top: 16px;'></div>", unsafe_allow_html=True)
    with st.container(border=True):
        st.markdown(render_card_header(
            "Firmware Fail-Safe Interlock Diagnostic Monitor",
            "7 Physical Safety Rules Evaluated Continuously"
        ), unsafe_allow_html=True)

        fs_checks = [
            {"Diagnostic Check": "Dry Run / No Flow", "Safety Rule": "Pump ON & Q < 0.05 L/min for > 3s", "Evaluated Signal": f"Q = {cur_flow:.2f} L/min", "Status": "PASS (Flow Active)" if cur_flow > 0.05 else ("TRIGGERED" if eng.dry_run_seconds >= 3 else f"Counting ({eng.dry_run_seconds}/3s)")},
            {"Diagnostic Check": "Siphon / Leak", "Safety Rule": "Pump OFF & Q > 0.10 L/min for > 3s", "Evaluated Signal": f"Q = {cur_flow:.2f} L/min", "Status": "PASS (No Siphon)" if eng.leak_seconds == 0 else f"Counting ({eng.leak_seconds}/3s)"},
            {"Diagnostic Check": "Temp Probe Limit", "Safety Rule": "Temp outside 0–50°C, or -127°C / 85°C", "Evaluated Signal": f"{cur_temp:.1f} °C", "Status": "PASS" if 0 <= cur_temp <= 50 and cur_temp not in (-127, 85) else "FAULT"},
            {"Diagnostic Check": "Turbidity Signal Range", "Safety Rule": "ADC reading < 100 mV or > 2400 mV", "Evaluated Signal": f"{frame.get('turb_mv', 2000):.0f} mV", "Status": "PASS" if 100 <= frame.get("turb_mv", 2000) <= 2400 else "OUT OF BOUNDS"},
            {"Diagnostic Check": "EC Probe In Air", "Safety Rule": "Resistance Rx > 200 kΩ", "Evaluated Signal": f"Rx = {sim.rx_ohms:.0f} Ω", "Status": "PASS" if sim.rx_ohms <= 200000 else "PROBE IN AIR"},
            {"Diagnostic Check": "EC Probe Shorted", "Safety Rule": "Resistance Rx < 50 Ω", "Evaluated Signal": f"Rx = {sim.rx_ohms:.0f} Ω", "Status": "PASS" if sim.rx_ohms >= 50 else "SCREWS SHORTED"},
            {"Diagnostic Check": "EC Polarization", "Safety Rule": "Bipolar pulse asymmetry > 20%", "Evaluated Signal": f"Asym = {sim.rx_asym*100:.1f}%", "Status": "PASS" if sim.rx_asym <= 0.20 else "POLARIZED / FOULED"}
        ]
        st.dataframe(pd.DataFrame(fs_checks), width="stretch")

# =========================================================
# PAGE 5: AREA RISK
# =========================================================
elif nav_selection == "Area Risk":
    st.markdown("""
    <div style="font-size: 13px; color: #68717D; margin-bottom: 16px; line-height: 1.5;">
        Regional groundwater hazard enforcement based on the <strong>Central Ground Water Board (CGWB) Annual Ground Water Quality Report 2024</strong>.
    </div>
    """, unsafe_allow_html=True)

    with st.container(border=True):
        st.markdown(render_card_header(
            "District Water-Risk Configuration & Live Evaluation",
            "CGWB 2024 Geological Groundwater Database"
        ), unsafe_allow_html=True)

        ar_col1, ar_col2 = st.columns([1.2, 1.8])
        with ar_col1:
            all_dists = sorted([d["name"] for d in lock_eng.districts.values()]) + ["Haldwani (Nainital)", "Other Unlisted District"]
            default_d_idx = 0
            if "Bareilly" in all_dists:
                default_d_idx = all_dists.index("Bareilly")

            dist_pick = st.selectbox("Select Target District", options=all_dists, index=default_d_idx)
            clean_d = dist_pick.split(" ")[0]

            src_pick = st.radio("Select Water Source", ["Groundwater (Borewell / Handpump)", "Piped (Municipal Supply)"], index=0)
            src_key = "groundwater" if "groundwater" in src_pick.lower() else "piped"

        with ar_col2:
            locked_eval, reason_eval = lock_eng.evaluate_lock(
                district_name=clean_d,
                water_source=src_key,
                test_result=st.session_state.current_test_record,
                current_date=datetime.now()
            )

            if locked_eval:
                st.markdown(clean_html(f"""
                <div style="background: #EDF4FA; border: 1px solid #93C5FD; padding: 14px 16px; border-radius: 4px; margin-bottom: 10px;">
                    <div style="display: flex; justify-content: space-between; align-items: center; margin-bottom: 4px;">
                        <span style="font-size: 13px; font-weight: 600; color: #2B5880;">AREA LOCKED TO RO+UV</span>
                        <span style="font-family: monospace; font-size: 10px; background: #CBE0F1; color: #2B5880; padding: 2px 6px; border-radius: 3px; font-weight: 600;">ENFORCED</span>
                    </div>
                    <div style="font-size: 12px; color: #4B5563; line-height: 1.4;">{reason_eval}</div>
                </div>
                """), unsafe_allow_html=True)

                if st.button("Sync RO Lock to Arduino (L1)", width="stretch"):
                    eng.area_locked = True
                    dispatch_serial_command("L1", f"Enforced RO lock for {clean_d}")
            else:
                st.markdown(clean_html(f"""
                <div style="background: #EBF5F0; border: 1px solid #C6E7D4; padding: 14px 16px; border-radius: 4px; margin-bottom: 10px;">
                    <div style="display: flex; justify-content: space-between; align-items: center; margin-bottom: 4px;">
                        <span style="font-size: 13px; font-weight: 600; color: #235E3F;">UNLOCKED — UF+UV ROUTE PERMITTED</span>
                        <span style="font-family: monospace; font-size: 10px; background: #C6E7D4; color: #235E3F; padding: 2px 6px; border-radius: 3px; font-weight: 600;">ACTIVE</span>
                    </div>
                    <div style="font-size: 12px; color: #4B5563; line-height: 1.4;">{reason_eval}</div>
                </div>
                """), unsafe_allow_html=True)

                if st.button("Release Lock on Arduino (L0)", width="stretch"):
                    eng.area_locked = False
                    dispatch_serial_command("L0", f"Released risk lock for {clean_d}")

            st.caption("Piped municipal supply bypasses area lock because centralized treatment removes heavy metal hazards. Groundwater from borewells enforces regional chemical risk.")

    # 4 Dedicated Contaminant Indicator Cards
    st.markdown("<div style='margin-top: 16px;'></div>", unsafe_allow_html=True)
    d_info = lock_eng.get_district_info(clean_d)
    d_flags = d_info["flags"] if d_info else {"arsenic": 0, "fluoride": 0, "nitrate": 0, "uranium": 0}

    test_rec = st.session_state.current_test_record
    t_vals = test_rec.get("values", {}) if test_rec else {}
    t_source = test_rec.get("source", "") if test_rec else ""
    is_t_valid = test_rec is not None

    c1, c2, c3, c4 = st.columns(4)
    with c1:
        st.markdown(render_contaminant_indicator_card(
            name="Arsenic",
            formula="As",
            bis_limit_str="< 10 µg/L",
            is_flagged=bool(d_flags.get("arsenic", 0)),
            test_value=t_vals.get("arsenic"),
            unit="µg/L",
            is_test_valid=is_t_valid and ("strip" not in t_source.lower()), # Rule 7: strip invalid for As
            test_source=t_source
        ), unsafe_allow_html=True)

    with c2:
        st.markdown(render_contaminant_indicator_card(
            name="Fluoride",
            formula="F",
            bis_limit_str="≤ 1.5 mg/L",
            is_flagged=bool(d_flags.get("fluoride", 0)),
            test_value=t_vals.get("fluoride"),
            unit="mg/L",
            is_test_valid=is_t_valid,
            test_source=t_source
        ), unsafe_allow_html=True)

    with c3:
        st.markdown(render_contaminant_indicator_card(
            name="Nitrate",
            formula="NO3",
            bis_limit_str="≤ 45 mg/L",
            is_flagged=bool(d_flags.get("nitrate", 0)),
            test_value=t_vals.get("nitrate"),
            unit="mg/L",
            is_test_valid=is_t_valid,
            test_source=t_source
        ), unsafe_allow_html=True)

    with c4:
        st.markdown(render_contaminant_indicator_card(
            name="Uranium",
            formula="U",
            bis_limit_str="≤ 30 µg/L",
            is_flagged=bool(d_flags.get("uranium", 0)),
            test_value=t_vals.get("uranium"),
            unit="µg/L",
            is_test_valid=is_t_valid,
            test_source=t_source
        ), unsafe_allow_html=True)

    st.markdown("<div style='margin-top: 16px;'></div>", unsafe_allow_html=True)
    c_tbl1, c_tbl2 = st.columns([1.3, 1.7])
    with c_tbl1:
        with st.container(border=True):
            st.markdown(render_card_header(
                "CGWB 2024 Ground Water Quality Survey Reference",
                "Official Documented Regional Exceedances"
            ), unsafe_allow_html=True)
            df_risk = pd.read_csv("district_risk.csv")
            st.dataframe(df_risk[["district", "state", "arsenic", "fluoride", "nitrate", "uranium"]], width="stretch", height=280)
            st.caption("Binary 1 represents documented exceedance of BIS IS 10500 permissible limits in CGWB monitoring wells.")

    with c_tbl2:
        with st.container(border=True):
            st.markdown(render_card_header(
                "Area Risk & Evidence Verification Rules",
                "Playbook Specification Rules 1 through 7"
            ), unsafe_allow_html=True)

            st.markdown(clean_html("""
            <div style="font-size: 12px; line-height: 1.6; color: #4B5563;">
                <div><strong>Rule 1 (Default Stance):</strong> Water sources default to their regional CGWB risk profile unless verified by an approved test on file.</div>
                <div><strong>Rule 2 (Groundwater Only):</strong> Regional lock applies exclusively to groundwater (borewells/handpumps). Piped municipal supply bypasses area lock.</div>
                <div><strong>Rule 3 (Unlisted Districts):</strong> Unlisted districts show <em>'No flag found'</em>, but are <strong>NEVER assumed safe</strong>.</div>
                <div><strong>Rule 4 (No Test on File):</strong> Any flagged groundwater parameter forces RO+UV until certified proof is submitted.</div>
                <div><strong>Rule 5 (Evidence Limits):</strong> Test reports must prove all flagged contaminants are strictly within BIS IS 10500 limits.</div>
                <div><strong>Rule 6 (Expiration &amp; Monsoon):</strong> Test certificates expire after 180 days (6 months). Nitrate re-locks post-monsoon due to agricultural runoff surges.</div>
                <div><strong>Rule 7 (Arsenic Strip Rejection):</strong> Colorimetric test strips CANNOT unlock Arsenic (54% false negative risk in field studies). Accredited lab certificate mandatory.</div>
            </div>
            """), unsafe_allow_html=True)

# =========================================================
# PAGE 6: TEST RESULTS
# =========================================================
elif nav_selection == "Test Results":
    st.markdown("""
    <div style="font-size: 13px; color: #68717D; margin-bottom: 16px; line-height: 1.5;">
        Certified evidence-based unlock registry. Enter dated laboratory or field kit test results to verify compliance with BIS IS 10500 limits.
    </div>
    """, unsafe_allow_html=True)

    with st.container(border=True):
        st.markdown(render_card_header(
            "Submit Certified BIS Water Quality Test Report",
            "Accredited Laboratory & Field Verification Deck"
        ), unsafe_allow_html=True)

        tc1, tc2 = st.columns(2)
        with tc1:
            f_src = st.selectbox(
                "Testing Authority / Source",
                ["Accredited Laboratory (NABL / CPCB)", "Jal Jeevan Mission (JJM) Field Kit", "Village Testing Center", "Advisory Colorimetric Test Strip"]
            )
            f_date = st.date_input("Test Sampling Date", value=date.today())
        with tc2:
            st.markdown("""
            <div style="background: #FDF6EB; border: 1px solid #F6DFB8; padding: 12px 14px; border-radius: 4px; font-size: 12px; color: #8C5E1B; line-height: 1.45;">
                <strong>Rule 7 (Arsenic Strip Rejection):</strong> Colorimetric test strips are advisory only and <strong>NEVER</strong> unlock Arsenic due to high false-negative risk (~54% in field studies). An accredited NABL laboratory report is mandatory to lift an Arsenic lock.
            </div>
            """, unsafe_allow_html=True)

        st.markdown("<div style='margin-top: 8px;'></div>", unsafe_allow_html=True)
        p1, p2, p3, p4 = st.columns(4)
        with p1:
            v_as = st.number_input("Arsenic (As) [µg/L]", value=4.0, step=0.5, help="BIS IS 10500 Limit: < 10 µg/L")
        with p2:
            v_f = st.number_input("Fluoride (F) [mg/L]", value=0.9, step=0.1, help="BIS IS 10500 Limit: ≤ 1.5 mg/L")
        with p3:
            v_no3 = st.number_input("Nitrate (NO3) [mg/L]", value=25.0, step=1.0, help="BIS IS 10500 Limit: ≤ 45 mg/L")
        with p4:
            v_u = st.number_input("Uranium (U) [µg/L]", value=12.0, step=1.0, help="BIS / AERB Limit: ≤ 30 µg/L")

        s_code = "lab"
        if "jjm" in f_src.lower() or "field kit" in f_src.lower():
            s_code = "field_kit"
        elif "village" in f_src.lower():
            s_code = "village"
        elif "strip" in f_src.lower():
            s_code = "test_strip"

        btn_s1, btn_s2 = st.columns(2)
        with btn_s1:
            if st.button("Register Certified Test Result", width="stretch"):
                st.session_state.current_test_record = {
                    "source": s_code,
                    "source_label": f_src,
                    "date": f_date.strftime("%Y-%m-%d"),
                    "values": {"arsenic": v_as, "fluoride": v_f, "nitrate": v_no3, "uranium": v_u}
                }
                st.toast("Test evidence registered in decision engine.")
        with btn_s2:
            if st.button("Clear Active Record", width="stretch"):
                st.session_state.current_test_record = None
                st.toast("Active test certificate removed.")

    # Active Certificate Registry & Verification Card
    st.markdown("<div style='margin-top: 16px;'></div>", unsafe_allow_html=True)
    with st.container(border=True):
        st.markdown(render_card_header(
            "Active Certificate Registry & Validity Expiry Tracker",
            "180-Day Regulatory Audit Trail"
        ), unsafe_allow_html=True)

        if st.session_state.current_test_record:
            rec = st.session_state.current_test_record
            t_date_obj = datetime.strptime(rec['date'], "%Y-%m-%d").date()
            expiry_date_obj = t_date_obj + timedelta(days=180)
            days_left = (expiry_date_obj - date.today()).days
            is_expired = days_left < 0

            days_badge = (
                f'<span style="color: #235E3F; background: #EBF5F0; border: 1px solid #C6E7D4; padding: 2px 8px; border-radius: 4px; font-weight: 600; font-size: 11px;">VALID ({days_left} DAYS LEFT)</span>'
                if not is_expired else
                f'<span style="color: #93302E; background: #FDF0ED; border: 1px solid #F7CECA; padding: 2px 8px; border-radius: 4px; font-weight: 600; font-size: 11px;">EXPIRED ({abs(days_left)} DAYS AGO)</span>'
            )

            st.markdown(clean_html(f"""
            <div style="background: #F9FAFB; border: 1px solid #E5E7EB; border-radius: 4px; padding: 12px 16px; margin-bottom: 14px;">
                <div style="display: flex; justify-content: space-between; align-items: center; margin-bottom: 6px;">
                    <div>
                        <span style="font-size: 13px; font-weight: 600; color: #20242B;">{rec.get('source_label', rec['source'].upper())}</span>
                        <span style="font-family: monospace; font-size: 12px; color: #68717D; margin-left: 8px;">Sampled: {rec['date']} &bull; Expires: {expiry_date_obj.strftime('%Y-%m-%d')}</span>
                    </div>
                    {days_badge}
                </div>
            </div>
            """), unsafe_allow_html=True)

            # Verification Table
            r_vals = rec["values"]
            is_strip = "strip" in rec["source"].lower()
            
            as_stat = "DISQUALIFIED (Rule 7: Strip rejected)" if is_strip else ("PASS" if r_vals["arsenic"] < 10.0 else "EXCEEDED")
            f_stat = "PASS" if r_vals["fluoride"] <= 1.5 else "EXCEEDED"
            no3_stat = "PASS" if r_vals["nitrate"] <= 45.0 else "EXCEEDED"
            u_stat = "PASS" if r_vals["uranium"] <= 30.0 else "EXCEEDED"

            check_data = [
                {"Contaminant": "Arsenic (As)", "Measured": f"{r_vals['arsenic']} µg/L", "BIS Limit": "< 10.0 µg/L", "Authority Check": "NABL Lab Required" if is_strip else "Valid Authority", "Compliance Status": as_stat},
                {"Contaminant": "Fluoride (F)", "Measured": f"{r_vals['fluoride']} mg/L", "BIS Limit": "≤ 1.5 mg/L", "Authority Check": "Accepted", "Compliance Status": f_stat},
                {"Contaminant": "Nitrate (NO3)", "Measured": f"{r_vals['nitrate']} mg/L", "BIS Limit": "≤ 45.0 mg/L", "Authority Check": "Monsoon check active", "Compliance Status": no3_stat},
                {"Contaminant": "Uranium (U)", "Measured": f"{r_vals['uranium']} µg/L", "BIS Limit": "≤ 30.0 µg/L", "Authority Check": "Accepted", "Compliance Status": u_stat},
            ]
            st.dataframe(pd.DataFrame(check_data), width="stretch")
        else:
            st.markdown("""
            <div style="font-size: 12px; color: #68717D; padding: 12px 0;">
                No certified water quality report currently registered on file. The decision engine enforces regional CGWB 2024 groundwater risk locks.
            </div>
            """, unsafe_allow_html=True)

# =========================================================
# PAGE 7: HISTORICAL LOGS
# =========================================================
elif nav_selection == "Historical Logs":
    st.markdown("""
    <div style="font-size: 13px; color: #68717D; margin-bottom: 16px; line-height: 1.5;">
        Immutable 1 Hz telemetry and decision event log conforming to the 15-column Playbook specification.
    </div>
    """, unsafe_allow_html=True)

    if not df_hist.empty:
        with st.container(border=True):
            st.markdown(render_card_header(
                "Telemetry Log Filter & Search",
                f"File: {st.session_state.log_filename}"
            ), unsafe_allow_html=True)

            flt_c1, flt_c2, flt_c3 = st.columns([1, 1.5, 1.5])
            with flt_c1:
                state_options = ["ALL"] + sorted(list(df_hist["state"].unique())) if "state" in df_hist.columns else ["ALL"]
                sel_state = st.selectbox("Filter State", options=state_options, index=0)
            with flt_c2:
                search_query = st.text_input("Search Reason / Tag", value="", placeholder="e.g. Nominal, BENCH_01...")
            with flt_c3:
                st.markdown("<div style='font-size: 11px; font-weight: 600; text-transform: uppercase; color: #68717D; margin-bottom: 6px;'>Session Telemetry Metrics</div>", unsafe_allow_html=True)
                st.markdown(f"<span style='font-family: monospace; font-size: 12px; color: #20242B;'><strong>{len(df_hist)}</strong> samples recorded &bull; Duration: <strong>{len(df_hist)}s</strong></span>", unsafe_allow_html=True)

            filtered_df = df_hist.copy()
            if sel_state != "ALL" and "state" in filtered_df.columns:
                filtered_df = filtered_df[filtered_df["state"] == sel_state]
            if search_query.strip() and "reason" in filtered_df.columns:
                q = search_query.strip().lower()
                filtered_df = filtered_df[
                    filtered_df["reason"].str.lower().str.contains(q) | 
                    filtered_df["tag"].str.lower().str.contains(q)
                ]

            st.dataframe(filtered_df, width="stretch", height=420)

            if os.path.exists(st.session_state.log_filename):
                with open(st.session_state.log_filename, "r", encoding="utf-8") as f:
                    csv_bytes = f.read()
                st.download_button(
                    "Export Full CSV Telemetry Log",
                    data=csv_bytes,
                    file_name=st.session_state.log_filename,
                    mime="text/csv"
                )
    else:
        st.info("No telemetry logged yet in current session.")

# =========================================================
# PAGE 8: CALIBRATION & SETTINGS
# =========================================================
elif nav_selection == "Calibration & Settings":
    st.markdown("""
    <div style="font-size: 13px; color: #68717D; margin-bottom: 16px; line-height: 1.5;">
        Hydraulic and physical sensor calibration deck. Update flow turbine constants, baseline voltages, and conductivity polynomials stored in EEPROM.
    </div>
    """, unsafe_allow_html=True)

    c_col1, c_col2 = st.columns(2)
    with c_col1:
        with st.container(border=True):
            st.markdown(render_card_header(
                "Flow Turbine Calibration (K Factor)",
                "YF-S401 Sensor Calibration"
            ), unsafe_allow_html=True)

            st.caption("Measure water into a graduated jug for 60 seconds with pump running. Formula: K = pulses ÷ litres. Nominal range: 4,500–5,500 pulses/L.")
            j_litres = st.number_input("Measured Jug Volume (Litres)", min_value=0.1, max_value=5.0, value=1.15, step=0.05)
            p_pulses = st.number_input("Recorded Flow Pulses (in 60s)", min_value=100, max_value=20000, value=5750, step=50)

            if st.button("Compute Flow K", width="stretch"):
                k_res = CalibrationHelper.calculate_flow_k(measured_litres=j_litres, pulse_count=int(p_pulses))
                st.session_state.cal_k_res = k_res

            if "cal_k_res" in st.session_state:
                res_k = st.session_state.cal_k_res
                st.markdown(f"**Calculated K:** `{res_k['k_flow']}` pulses/L | **Flow Rate:** `{res_k['calculated_flow_lpm']}` L/min")
                k_save_confirm = st.checkbox("Confirm save K factor to EEPROM", key="chk_k_save")
                if st.button("Save K to EEPROM (K<n>)", disabled=not k_save_confirm, width="stretch"):
                    eng.set_calibration(k_flow=res_k['k_flow'])
                    dispatch_serial_command(res_k['command_arduino'], f"Flow calibration constant saved as {res_k['k_flow']}")

            st.markdown("<div style='margin-top: 14px; padding-top: 10px; border-top: 1px solid #E5E7EB;'></div>", unsafe_allow_html=True)
            st.markdown("<div style='font-size: 11px; font-weight: 600; text-transform: uppercase; color: #68717D; margin-bottom: 6px;'>Fresh Cartridge Baseline (Q0)</div>", unsafe_allow_html=True)
            st.markdown(f"<div style='font-size: 12px; color: #4B5563; margin-bottom: 8px;'>Current Stored Q0: <strong>{eng.cal.q0_fresh_flow:.2f} L/min</strong> | Live Flow: <strong>{cur_flow:.2f} L/min</strong></div>", unsafe_allow_html=True)
            q0_confirm = st.checkbox("Confirm save fresh filter flow baseline", key="chk_q0_save")
            if st.button("Save Live Flow as Q0 Baseline (F)", disabled=not q0_confirm, width="stretch"):
                eng.reset_baseline_q0(cur_flow)
                dispatch_serial_command("F", f"Saved fresh cartridge flow baseline Q0 = {cur_flow:.2f} L/min")

        with st.container(border=True):
            st.markdown(render_card_header(
                "Turbidity Clear-Water Baseline (V0)",
                "Optical Tip Phototransistor"
            ), unsafe_allow_html=True)

            cur_mv = frame.get("turb_mv", 2000.0)
            st.markdown(f"<div style='font-size: 12px; color: #4B5563; margin-bottom: 8px;'>Current Stored V0: <strong>{eng.cal.v0_turb_mv:.0f} mV</strong> | Live Sensor ADC: <strong>{cur_mv:.1f} mV</strong></div>", unsafe_allow_html=True)
            v0_confirm = st.checkbox("Confirm clear-water baseline calibration", key="chk_v0_save")
            if st.button("Save Current Voltage as V0 (B)", disabled=not v0_confirm, width="stretch"):
                eng.reset_baseline_v0(cur_mv)
                dispatch_serial_command("B", f"Saved optical tip clear-water baseline V0 = {cur_mv:.0f} mV")

    with c_col2:
        with st.container(border=True):
            st.markdown(render_card_header(
                "Bipolar Conductivity Standard Curve Fit",
                "5-Point NaCl Standard Calibration Matrix"
            ), unsafe_allow_html=True)

            st.caption("5-point table salt standard calibration matrix against reference TDS meter.")
            salt_matrix = [
                {"salt_g_per_l": 0.0, "rx_ohms": 2800.0, "pen_ec_uScm": 250.0},
                {"salt_g_per_l": 0.25, "rx_ohms": 1400.0, "pen_ec_uScm": 510.0},
                {"salt_g_per_l": 0.50, "rx_ohms": 820.0, "pen_ec_uScm": 860.0},
                {"salt_g_per_l": 1.00, "rx_ohms": 480.0, "pen_ec_uScm": 1520.0},
                {"salt_g_per_l": 2.00, "rx_ohms": 270.0, "pen_ec_uScm": 2850.0},
            ]
            st.dataframe(pd.DataFrame(salt_matrix), width="stretch")

            if st.button("Fit Conductivity Polynomial", width="stretch"):
                fit_out = CalibrationHelper.fit_conductivity_curve(salt_matrix)
                st.session_state.fit_out = fit_out

            if "fit_out" in st.session_state:
                fo = st.session_state.fit_out
                st.markdown(f"**Fit Quality (R²):** `{fo['r_squared']}` | a=`{fo['ec_a']}`, b=`{fo['ec_b']}`, c=`{fo['ec_c']}`")
                st.code(fo["arduino_snippet"], language="c")

        with st.container(border=True):
            st.markdown(render_card_header(
                "Hardware Sensor Diagnostic Status",
                "ATmega328P ADC & Bus Health"
            ), unsafe_allow_html=True)

            sensor_diag_data = [
                {"Sensor": "Dallas DS18B20", "Bus / Pin": "Pin D4 (1-Wire)", "Nominal Range": "0.0 – 50.0 °C", "Status": "PASS (0.06°C noise)"},
                {"Sensor": "YF-S401 Flow Turbine", "Bus / Pin": "Pin D2 (INT0)", "Nominal Range": "0.30 – 1.50 L/min", "Status": "PASS (5000 p/L)"},
                {"Sensor": "Optical Turbidity Tip", "Bus / Pin": "Pin A0 (ADC)", "Nominal Range": "100 – 2400 mV", "Status": "PASS (V0=2000 mV)"},
                {"Sensor": "SS304 Bipolar Probe", "Bus / Pin": "Pins D7, D8, A1", "Nominal Range": "50 – 200,000 Ω", "Status": "PASS (Symmetric)"},
                {"Sensor": "Manometer Head", "Bus / Pin": "Vertical Tube", "Nominal Range": "5.0 – 25.0 cm", "Status": "PASS (Hydrostatic)"},
            ]
            st.dataframe(pd.DataFrame(sensor_diag_data), width="stretch")
